aswinpraabu/RC-CAR/Hardware_Files/Front Wheel Hub.png

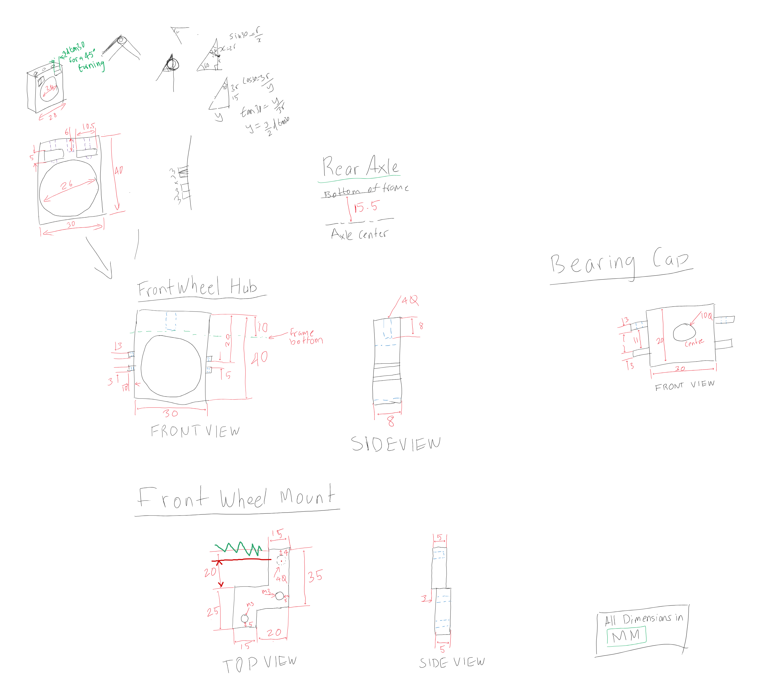
Hardware_Files/Front Wheel Hub.png
