aswinpraabu/RC-CAR/Hardware_Files/FreeCAD_Project_Files/Front_Wheel_Mount.FCStd

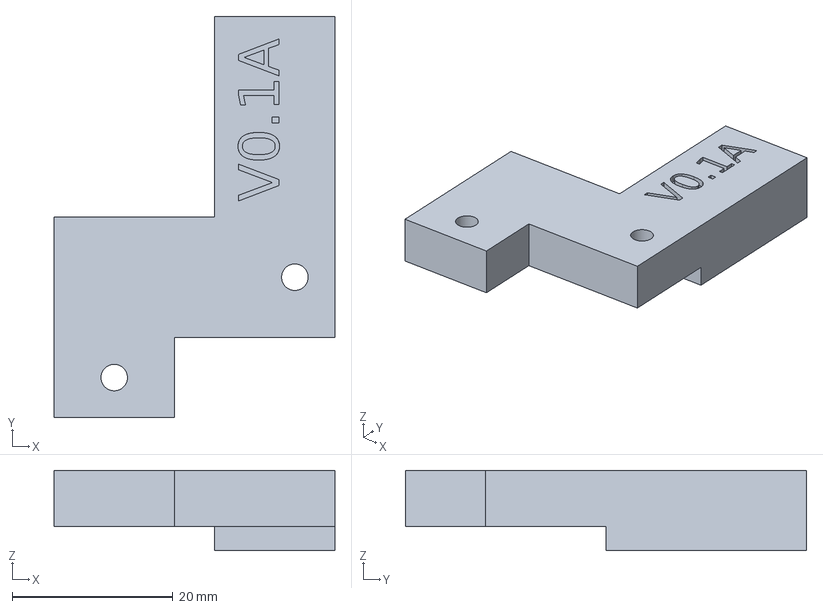
[picture p2: CAD file, 2025-08-28]
Hardware_Files/FreeCAD_Project_Files/Front_Wheel_Mount.FCStd
35.0 x 50.0 x 10.0 mm
