aswinpraabu/RC-CAR/Hardware_Files/FreeCAD_Project_Files/Front_Wheel_Hub.FCStd

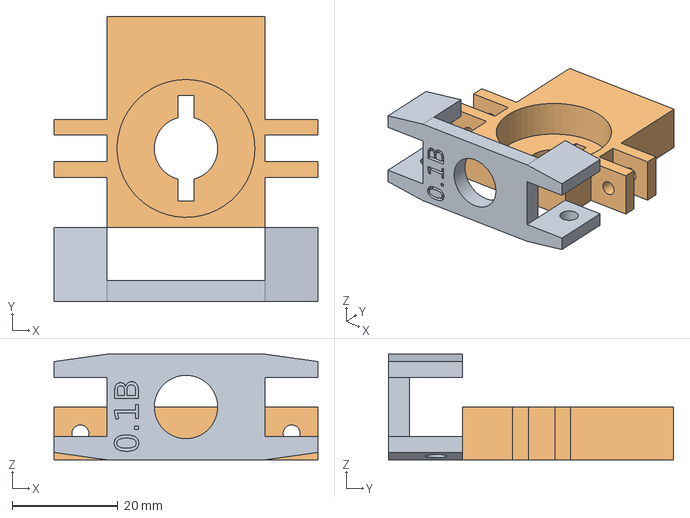
[picture p3: CAD file, 2025-08-28]
Hardware_Files/FreeCAD_Project_Files/Front_Wheel_Hub.FCStd
50.0 x 54.0 x 20.0 mm
Bearing_Cap_V0.1B
Wheel_Hub_V0.1A
