aswinpraabu/RC-CAR/Hardware_Files/FreeCAD_Project_Files/Frame.FCStd

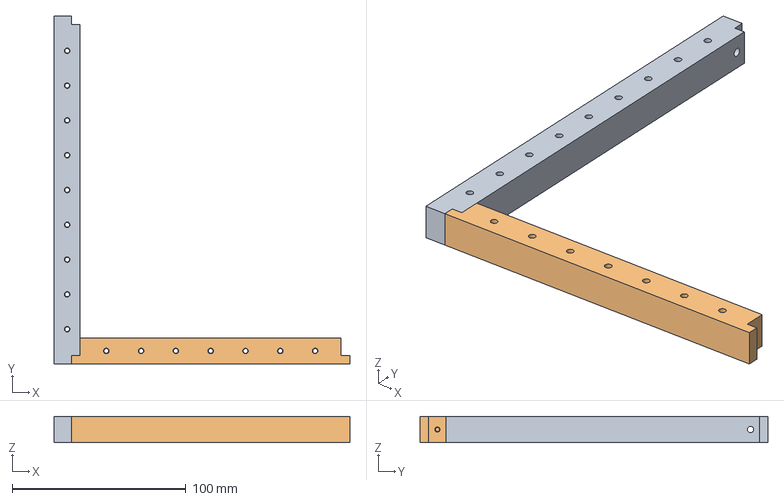
[picture p4: CAD file, 2025-02-16]
Hardware_Files/FreeCAD_Project_Files/Frame.FCStd
170.0 x 200.0 x 15.0 mm
Side_Frame
