aswinpraabu/RC-CAR/(threads)

Thread 3 (2025-02-16):

[HW Feature] Front Axle & Steering (Driven Axle) Proto1

aswinpraabu, 2025-02-16:
**Describe the feature**
Design, make and assemble the  Front Axle & Steering system
- [ ] Make part(s) that attaches the front wheels and can rotate around the z-axis (perpendicular to the ground)
- [ ] Make parts for the steering system
- [ ] Assemble everything

**Describe implementation ideas you've considered**

- To make a wheel hub that attaches to the frame (or another part fixed to the frame) with a dowel pin
  - The frame essentially sits on the wheels. If the car is lifted with the frame the wheels will fall off :D. Need to come up with something better later
- Two more dowel pins on each wheel hub to attach two rods that will together form a parrallelogram.
  - A servo motor will provide steering

aswinpraabu, 2025-03-22:
Abandoning Proto1 as it's pretty unstable and poorly designed

Closed 2025-03-20.

Thread 6 (2025-02-16):

[HW Feature]  Servo Motor for Steering

aswinpraabu, 2025-02-16:
**Describe the feature**
Choose & purchase a Servo Motor for the steering system

aswinpraabu, 2025-04-13:
SG90 Servo Motor

Closed 2025-04-13.

Thread 7 (2025-02-20):

[HW Issue] It is difficult to remove the bearing from the Front Wheel Hub

aswinpraabu, 2025-02-20:
**Describe the bug**
 - There's no easy way to remove bearing from the Front Wheel Hub

aswinpraabu, 2025-02-21:
[commit 4c8498c](https://github.com/aswinpraabu/RC-CAR/commit/4c8498cbe6873c0d7bac48105ede0b8033901ee6) fixes this

aswinpraabu, 2025-02-21:
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

Closed 2025-02-22.

Thread 8 (2025-02-20):

[HW Issue] Bearing Cap doesn't fit onto the Front Wheel Hub

aswinpraabu, 2025-02-20:
**Describe the bug**
The dimensions of the cavity in the Bearing Cap should be slightly increased to acount for printing tolerances

aswinpraabu, 2025-02-21:
Likely don't need to make changes as later prints fit well

Closed 2025-02-28.

Thread 10 (2025-02-21):

[HW Issue] Hole size for the axle in the Front wheel hub is too small

aswinpraabu, 2025-02-21:
**Describe the bug**
The size is the exact size of the axle. This could lead to unwanted friction between the axle & the hub

aswinpraabu, 2025-02-21:
[commit deafaa0](https://github.com/aswinpraabu/RC-CAR/commit/deafaa024a08d10c39b107264ef8e12765498109) fixes this

Closed 2025-02-22.

Thread 11 (2025-02-21):

[HW Issue] Print fails for the front wheel mount

aswinpraabu, 2025-02-21:
**Describe the bug**
The fillet makes the print fail

aswinpraabu, 2025-02-21:
[commit ec0d887](https://github.com/aswinpraabu/RC-CAR/commit/ec0d887e8b5a94393507b226e7519ec388fa1986)

Closed 2025-02-22.

Thread 12 (2025-02-21):

[HW Issue] The hole in the Bearing cap doesn't allign with the hole in the hub

aswinpraabu, 2025-02-21:
**Describe the bug**

Closed 2025-02-22.

Thread 9 (2025-02-21):

[HW Issue] Bearing Cap doesn't have a cavity which blocks the axle

aswinpraabu, 2025-02-21:
**Describe the bug**

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

aswinpraabu, 2025-02-21:
[commit c9b6083](https://github.com/aswinpraabu/RC-CAR/commit/c9b608333f4c41ff2e303234c01f839d3ba8c90e) fixes this

Closed 2025-02-22.

Thread 13 (2025-02-22):

[HW Issue] The wheel hub cannot turn while mounted

aswinpraabu, 2025-02-22:
**Describe the bug**
There's no clearance between the hub & frame to allow the Hub to rotate
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

aswinpraabu, 2025-02-22:
[commit af77648](https://github.com/aswinpraabu/RC-CAR/commit/af776487be98671246623b77c50b3347bbf78bdb)

Thread 14 (2025-02-23):

[HW Issue] Bearing cap needs a cavity in the bottom to hold the dowel pin

aswinpraabu, 2025-02-23:
**Describe the bug**

Closed 2025-02-23.

Thread 22 (2025-04-05):

[HW Feature] Steering Servo Motor Mount

aswinpraabu, 2025-04-05:
**Describe the feature**

**Describe implementation ideas you've considered**

aswinpraabu, 2025-04-13:
SG90 Servo Motor

Closed 2025-05-04.

Thread 25 (2025-04-05):

[HW Issue] Spindle Bracket wobbles after mouting to the frame. Single fastening point is not enough

aswinpraabu, 2025-04-05:
**Describe the bug**

Closed 2025-05-04.

Thread 26 (2025-04-12):

[HW Issue] Need a stopper for the wheel to secure it to the axle

aswinpraabu, 2025-04-12:
**Describe the bug**

Closed 2025-05-10.

Thread 27 (2025-04-12):

[HW Issue] The length of the spindle is incorrect

aswinpraabu, 2025-04-12:
**Describe the bug**
The length of the spindle needs to be re-calculated to prevent the front wheel from making contact with the frame when turning

Closed 2025-05-04.

Thread 28 (2025-04-12):

[HW Issue] Spindle Bracket dimensions are incorrect

aswinpraabu, 2025-04-12:
**Describe the bug**
The dimensions of the spindle bracket needs to be re-calculated to prevent the front wheel from making contact with the frame when turning

Closed 2025-05-03.

Thread 30 (2025-05-03):

[HW Issue] The Servo mount needs screw holes to fasten the servo

aswinpraabu, 2025-05-03:
**Describe the bug**

Closed 2025-05-04.

Thread 31 (2025-05-04):

[HW Issue] Servo doesn't fit into the mount properly

aswinpraabu, 2025-05-04:
**Describe the bug**

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

Closed 2025-05-04.

Thread 35 (2025-05-04):

[HW Issue] Move the Rear Bearing mounts towards the edge of the frame to reduce bending stress on the rear axles

aswinpraabu, 2025-05-04:
**Describe the bug**

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

Closed 2025-05-07.

Thread 39 (2025-05-04):

[HW Feature] Rear wheel lock

aswinpraabu, 2025-05-04:
**Describe the feature**
A part to secure the rear wheel to the axle

aswinpraabu, 2025-05-06:
Don't need this, the axle will be secured to the wheel directly with a screw

Closed 2025-05-10.

Thread 40 (2025-05-06):

[HW Issue] Rear axle doesn't have a screw hole to be secured to the wheel

aswinpraabu, 2025-05-06:
**Describe the bug**

Thread 41 (2025-05-07):

[HW Issue] The Rear Axle is short by 7.5mm

aswinpraabu, 2025-05-07:
**Describe the bug**

Thread 42 (2025-05-07):

[HW Issue] The Rear Axle doesn't have a screw hole to be able the secure the wheel

aswinpraabu, 2025-05-07:
**Describe the bug**

Thread 47 (2025-05-10):

[HW Issue] Spacing between screw holes for the motor driver is a little too short

aswinpraabu, 2025-05-10:
**Describe the bug**
The current distance between the screw holes is 36mm. One of the sides can be a slot instead of a circle for better flexibility

The screw currently has to be driven at an angle in order to secure the motor mount.

Thread 48 (2025-05-10):

[HW Issue] Motor mount needs some cavity to through hole pins below the PCB

aswinpraabu, 2025-05-10:
**Describe the bug**

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

Closed 2025-06-01.
