aswinpraabu/RC-CAR/Software_Files/CCM/CCM_Submodules/hw_drivers.py

from CCM_Submodules.global_data import hw_drivers_data, rf_comms_data, controls_data
from CCM_Submodules.global_data import POWER_MODES, diagnostics_class
from machine import SPI, Pin,PWM, soft_reset, I2C
from CCM_Submodules.calibrations import HW_DRIVERS_Calibrations as CAL
from CCM_Libraries.ina260 import INA260, AveragingCount, ConversionTime
from time import sleep_ms, ticks_diff, ticks_ms

# region RFM69
# Define pin numbers for RFM69 module
RFM69_MOSI_PIN = 19
RFM69_MISO_PIN = 16
RFM69_SCK_PIN = 18
RFM69_CS_PIN = 17
RFM69_RESET_PIN = 20
a = PWM(Pin(RFM69_MOSI_PIN), freq=1000000)  # Example PWM initialization, adjust as needed
a.duty_ns()

# endregion
SERVO_PIN = 21
LED2_LOC_RCM_PIN = 'LED'

MOTOR_FWD_PIN = 11
MOTOR_REV_PIN = 10

POWER_ON_PIN_NUM = 13
POWER_ON_PIN = Pin(POWER_ON_PIN_NUM, Pin.OUT)
POWER_ON_PIN.value(1)  # Set high to power on the system

LED2 = Pin(LED2_LOC_RCM_PIN, Pin.OUT)
LED2.value(0)  # Turn off LED initially

# region INA260 
# (I2C) - Battery Voltage and Current Sensor
# I2C pins
I2C_SCL_PIN = 5
I2C_SDA_PIN = 4

INA260_ADDR = 0x40
# endregion

class Servo:
    def __init__(self):
        pass

    def configure_pin(self, pin):

        # Initialize the parameters for the SG90 servo motor
        self.pin = Pin(pin, Pin.OUT)
        self.angle = 0  # Initialize angle to 0 degrees
        self.min_angle = -90.0  # Minimum angle
        self.max_angle = 90.0 # Maximum angle
        self.min_duty_ns = 1.0e6 # (1ms) Minimum duty cycle in nanoseconds
        self.max_duty_ns = 2.0e6 # (2ms)Maximum duty cycle in nanoseconds
        self.freq = CAL.CAL_f_servo_freq

        self.min_duty_offset_ms = CAL.CAL_t_servo_min_duty_offset_ms # Offset for minimum duty cycle
        self.max_duty_offset_ms = CAL.CAL_t_servo_max_duty_offset_ms # Offset for maximum duty cycle
        self.min_duty_ns += int(self.min_duty_offset_ms * 1e6)  # Convert ms to ns
        self.max_duty_ns += int(self.max_duty_offset_ms * 1e6)  # Convert ms to ns
        
        self.pwm = PWM(self.pin, freq=self.freq)


    def set_angle(self, angle):
        self.angle = angle
        
        duty_ns = self._angle_to_duty_ns(angle)
        self.pwm.duty_ns(duty_ns)

    def _angle_to_duty_ns(self, angle: float) -> int:
        '''
        Convert angle to duty cycle in ns
        '''
        duty_ns:int = 0
        if angle < self.min_angle or angle > self.max_angle:
            print(f"Angle must be between {self.min_angle} and {self.max_angle} degrees")
            duty_ns = int(( self.max_duty_ns + self.min_duty_ns)/2)
        else:    
            factor = (self.max_duty_ns - self.min_duty_ns)/(self.max_angle - self.min_angle)
            duty_ns = int((angle - self.min_angle) * factor + self.min_duty_ns)
        #print(f"Setting servo angle to {angle} degrees, duty_ns: {duty_ns}")
        return duty_ns

class DC_Motor:
    def __init__(self):
        pass
    def configure_pin(self, forward_pin_num, reverse_pin_num):
        # Initialize the parameters for the DC motor
        self.forward_pin = Pin(forward_pin_num, Pin.OUT)
        self.reverse_pin = Pin(reverse_pin_num, Pin.OUT)

        self.frequency = 1000  # Frequency for PWM
        self.forward_pwm = PWM(self.forward_pin, freq=self.frequency)
        self.reverse_pwm = PWM(self.reverse_pin, freq=self.frequency)
        self.forward_pwm.duty_ns(0)  # Initialize duty cycle to 0
        self.reverse_pwm.duty_ns(0)  # Initialize duty cycle to 0

        self.power = 0 #Positive power for forward, negative for reverse
        self.min_power = -100  # Minimum power
        self.max_power = 100  # Maximum power
    def set_power(self, power):
        # Set the power of the motor
        
        #print(f"Setting motor power to {power}, duty_ns: {duty_ns}")

        if power > 0:
            duty_ns = self._power_to_duty_ns(power)
            self.forward_pwm.duty_ns(duty_ns)
            self.reverse_pwm.duty_ns(0)
        elif power < 0:
            duty_ns = self._power_to_duty_ns(power*CAL.CAL_p_dc_motor_reverse_factor/100)
            self.forward_pwm.duty_ns(0)
            self.reverse_pwm.duty_ns(int(duty_ns)) # Reverse motor at half power
        else:
            self.forward_pwm.duty_ns(0)
            self.reverse_pwm.duty_ns(0)
        
        
    def _power_to_duty_ns(self, power: float) -> int:
        '''
        Convert power to duty cycle in ns. Period is 1/freqency = 1/1000Hz = 1ms = 1000000ns
        '''
        duty_ns:int = 0
        is_in_range = self.min_power <= power <= self.max_power
        if not is_in_range:
            print(f"power must be between {self.min_power} and {self.max_power}")
            duty_ns = 0
        else:    
            #TODO this deadzone logic should account for battery voltage and current load
            # Actual deadzone may increase if battery voltage is low or motor is under load
            factor = (self.max_power - CAL.CAL_p_dc_motor_deadzone)/self.max_power 
            power_scaled = abs(power) * factor + CAL.CAL_p_dc_motor_deadzone # Scale power to overcome motor deadzone
            #print(f"Power: {power}, Scaled Power: {power_scaled}")
            duty_ns = int((power_scaled * 10000)) # percent to ns
        return duty_ns

steering_servo = Servo()
propulsion_motor = DC_Motor()
def initialize():
    print("Initializing hardware drivers...")

    # Initialize INA260 sensor
    global ina260_sensor
    i2c_obj = I2C(0, scl=Pin(I2C_SCL_PIN), sda=Pin(I2C_SDA_PIN))
    ina260_sensor = INA260(i2c_obj, INA260_ADDR)
    if ina260_sensor.init_success:
        ina260_sensor.voltage_conversion_time = CAL.CAL_t_ina260_voltage_conversion_time
        ina260_sensor.current_conversion_time = CAL.CAL_t_ina260_current_conversion_time
        ina260_sensor.averaging_count = CAL.CAL_n_ina260_averaging_count

    # Initialize RFM69 SPI and pins
    hw_drivers_data.rfm69_SPI = SPI(
                                    0,
                                    baudrate=500_000,
                                    polarity=0,
                                    phase=0,
                                    bits=8,
                                    firstbit=SPI.MSB,
                                    sck=Pin(RFM69_SCK_PIN),# type: ignore
                                    mosi=Pin(RFM69_MOSI_PIN),# type: ignore
                                    miso=Pin(RFM69_MISO_PIN)# type: ignore
                                    )
    hw_drivers_data.rfm69_CS = Pin(RFM69_CS_PIN, Pin.OUT)
    hw_drivers_data.rfm69_RESET = Pin(RFM69_RESET_PIN, Pin.OUT)

    steering_servo.configure_pin(SERVO_PIN)
    propulsion_motor.configure_pin(MOTOR_FWD_PIN, MOTOR_REV_PIN)

    hw_drivers_data.battery_voltage_low_warn_diag = diagnostics_class(
                                    id=1,
                                    name="Battery Voltage Low Warn",
                                    mature_time=CAL.CAL_t_battery_low_warn_mature_time_ms,
                                    demature_time=CAL.CAL_t_battery_low_warn_demature_time_ms
                                    )
    hw_drivers_data.battery_voltage_low_critical_diag =  diagnostics_class(
                                    id=2,
                                    name="Battery Voltage Low Critical",
                                    mature_time=CAL.CAL_t_battery_low_critical_mature_time_ms,
                                    demature_time=CAL.CAL_t_battery_low_critical_demature_time_ms
                                    )

# region Ouput
def led_control():
    LED2.value(controls_data.led2_loc_rcm)

def motor_control():

    #steering_servo.set_angle(controls_data.car_turn_angle)
    propulsion_motor.set_power(controls_data.car_throttle)
    #print(f"Steering angle: {controls_data.car_turn_angle}, Motor power: {controls_data.car_throttle}")

def power_control():
    if controls_data.power_mode == POWER_MODES.Shutdown:
        POWER_ON_PIN.value(0)

# endregion

# region input
def read_battery_voltage():
    if ina260_sensor.init_success:
        voltage = ina260_sensor.voltage  # Voltage 
        hw_drivers_data.battery_voltage = voltage  # Convert to volts
        hw_drivers_data.battery_voltage_validity = True  # Assume reading is valid for now
    else:
        hw_drivers_data.battery_voltage = 0.0
        hw_drivers_data.battery_voltage_validity = False

def read_battery_current():
    if ina260_sensor.init_success:
        current = ina260_sensor.current  # Current in milliamps
        hw_drivers_data.battery_current = current  # Already in milliamps
        hw_drivers_data.battery_current_validity = True  # Assume reading is valid for now
    else:
        hw_drivers_data.battery_current = 0.0
        hw_drivers_data.battery_current_validity = False

# endregion

def hw_drivers_diagnostics():
    #TODO [RC-78,RC-77]: Add diagnostics for battery voltage

    if hw_drivers_data.battery_voltage_validity:
        # Check Battery Voltage Critical first
        if hw_drivers_data.battery_voltage < CAL.CAL_v_battery_low_critical:
            hw_drivers_data.battery_voltage_low_critical_diag.test_fail()
        else:
            hw_drivers_data.battery_voltage_low_critical_diag.test_pass()

        # Then check Battery Voltage Warn
        if hw_drivers_data.battery_voltage < CAL.CAL_v_battery_low_warn:
            hw_drivers_data.battery_voltage_low_warn_diag.test_fail()
        else:
            hw_drivers_data.battery_voltage_low_warn_diag.test_pass()
    
            
    #TODO [RC-92]:Add diagnostics for current sensors
    pass


def task_005ms():
    '''
    This function is called every 5ms to update the servo position based on the received data.
    '''
    motor_control()
    read_battery_current()

def task_100ms():
    led_control()
    power_control()
    read_battery_voltage()
    hw_drivers_diagnostics()
    #print(f"Battery Voltage: {hw_drivers_data.battery_voltage:.2f} V, Battery Current: {hw_drivers_data.battery_current:.2f} mA")


if __name__ == "__main__":
    initialize()
    while True:
        task_005ms()
        task_100ms()
        sleep_ms(500)
