aswinpraabu/RC-CAR/Software_Files/CCM/CCM_Submodules/controls.py

from CCM_Submodules.global_data import rf_comms_data, controls_data, hw_drivers_data
from CCM_Submodules.global_data import POWER_MODES, DIAG_STATUS
from time import ticks_ms, ticks_diff
from CCM_Submodules.calibrations import CONTROLS_Calibrations as CAL


Prepare_Shutdown_start_time = 0  # Time when Prepare_Shutdown mode started


def initialize():
    pass


def motor_control():
    #print(rf_comms_data.rx_validity, controls_data.power_mode)

    # Check if all conditions are met to enable driving
    comms_data_check = rf_comms_data.rx_validity
    power_mode_check = controls_data.power_mode == POWER_MODES.Normal
    safety_check = hw_drivers_data.battery_voltage_low_critical_diag.get_status() is not DIAG_STATUS.FAIL
    drive_enable = all([comms_data_check, power_mode_check, safety_check])

    if drive_enable:
        # Update car throttle and turn angle based on received data
        controls_data.car_throttle = rf_comms_data.rx_throttle
        controls_data.car_turn_angle = rf_comms_data.rx_turn_angle
    else:
        # If data is invalid or not in Normal mode, stop the car
        controls_data.car_throttle = 0
        
        


def power_control():
    global Prepare_Shutdown_start_time

    any_shutdown_condition = any([
        rf_comms_data.shutdown_request_confirmed,
        rf_comms_data.LOC_with_RCM_diag.get_status() is DIAG_STATUS.FAIL,
        hw_drivers_data.battery_voltage_low_critical_diag.get_status() is DIAG_STATUS.FAIL])

    
    if controls_data.power_mode == POWER_MODES.Normal and any_shutdown_condition:
        # Transition to Prepare_Shutdown mode
        controls_data.power_mode = POWER_MODES.Prepare_Shutdown
        
        Prepare_Shutdown_start_time = ticks_ms()
        print("Transitioning to Prepare_Shutdown mode")

    elif controls_data.power_mode == POWER_MODES.Prepare_Shutdown:
        elapsed_time = ticks_diff(ticks_ms(), Prepare_Shutdown_start_time)
        if elapsed_time >= CAL.CAL_t_Prepare_Shutdown_duration_ms:
            # Transition to Shutdown mode after the duration
            controls_data.power_mode = POWER_MODES.Shutdown
            print("Transitioning to Shutdown mode")

def warning_lights_control():
    controls_data.led2_loc_rcm = rf_comms_data.LOC_with_RCM





def task_005ms():
    # Update motor control based on received data
    motor_control()
    


def task_010ms():
    # Update power control if needed
    power_control()


def task_100ms():
    # Update warning lights based on communication status
    warning_lights_control()
    #print("Turn angle: {0}, Throttle: {1}, Power Mode: {2}".format(controls_data.car_turn_angle,controls_data.car_throttle, controls_data.power_mode))
