aswinpraabu/RC-CAR/(commit log)

2024-06-16 added data struct definitions needed for voltage diagnostics
2025-02-16 Moving all the software files into a new folder because I'm going to track hardware here too
2025-02-16 Adding the hardware folder with the CAD file for the frames
    [Frame.FCStd]
2025-02-20 Added reference sketch for the front wheel hub
2025-02-20 Made the Wheel Hub & Bearing Cap based on sketch
    [Front_Wheel_Hub.FCStd]
2025-02-21 Added a hole for the axle in the bearing cap
    [Front_Wheel_Hub.FCStd]
2025-02-21 Increased the holes size from 10mm to 12mm in the front bearing hub
    [Front_Wheel_Hub.FCStd]
2025-02-21 Added cuts in the Fron Bearing hub
    [Front_Wheel_Hub.FCStd]
2025-02-21 Created design of Front Wheel Mount based on sketch
    [Front_Wheel_Mount.FCStd]
2025-02-21 Adjusted to help with allignment issue with the cap
    [Front_Wheel_Hub.FCStd]
2025-02-21 Suppressed Fillet for now to help with better print bed adhesion
    [Front_Wheel_Mount.FCStd]
2025-02-22 Fixed the dimensioning of the front wheel mount
2025-02-22 Fixed the issue in the Front wheel mount being too short
    [Front_Wheel_Mount.FCStd]
2025-02-22 Added a version naming into the model
    [Front_Wheel_Mount.FCStd]
2025-02-23 Added a cavity in the bottom to hold the dowel pin
    [Front_Wheel_Hub.FCStd]
2025-06-25 fixed issues with importing global_data
    [hw_drivers.py]
2025-06-25 Finished implementing RF receiving. And fixed issues with receiving RF messages
    [rf_comms.py]
2025-06-25 Added a Servo class
2025-07-02 implement basic servo control functionality
2025-07-02 Creating module to control all actuators
2025-07-02 Added offsets to the min & max angle. To account for imperfect motors
2025-08-14 updated the getter function for turning & throttle to be more specific
2025-08-16 created the DC_Motor class to handle motor actuation
2025-08-16 added warning LEDs
2025-08-16 implemented functionality to drive the prop motor based on the output from "controls"
2025-08-16 Allow throttle input to accept [-50, 100] to allow for reversing
    [rf_comms.py]
2025-08-16 Changing to getting reverse throttle upto -100. But Drive the motor at 50% power when reversing
    [hw_drivers.py, rf_comms.py]
2025-08-16 Changed pin numbers for the propulsion motor
2025-08-17 RC-74 Moved the shutdown command reset logic, to allow reseting status even after confirming the command
    [rf_comms.py]
2025-08-17 implemented ability to set power pin low on shutdown
2025-08-17 don't reset the turn angle abruptly during shutdown. Retain last angle
    [controls.py]
2025-08-17 added power_control to 100ms task
2025-08-17 print statements
2025-08-17 RC-85 safely handle condition where CCM fails toconnect to the RF tranceiver
    [rf_comms.py]
2025-08-17 print statement
2025-08-19 Onboard LED Pin reference name changed in PICO 2 W
2025-08-19 RC-90 Assign the correct pin numbers
    [hw_drivers.py]
2025-08-19 RC-90 Fixed incorrect conversion from power to duty cycle for dc motor
    [hw_drivers.py]
2025-08-21 RC-83, RC-84 created a calibration to for the shutdown timeout
2025-08-22 RC-83 Define calibration variables in a separate file with a specific format
2025-08-25 RC-76 Pin configurations for INA260
2025-08-25 RC-76 Initialize the INA260 sensor
2025-08-25 RC-76 adding calibrations for INA260
2025-08-25 RC-76 added interfaces to provide voltage & current readings to other submodules
2025-08-25 declaring all the calibrations as constants
2025-08-26 RC-76 added functions to read the voltage & current
2025-08-26 Fixed conversion issue. The library already converts mv to volts
    [hw_drivers.py]
2025-08-26 RC-76 class RWBits was still for circuit python. Updated for micropython
2025-08-27 RC-68 RC-77 RC-78 added calibrations to required for detecting battery low voltage faults
2025-08-27 RC-68 RC-77 RC-78 adding interfaces for hw_drivers to provide the status of battery low voltage faults
2025-08-27 RC-68 RC-77 RC-78 implemented diagnostics to detect low battery voltage
2025-08-28 Reduced the font of the version number to fit better
    [Front_Wheel_Hub.FCStd]
2025-08-28 RC-96 change ">" to ">=" to include 0% throttle
2025-08-28 RC-98 Added checks to only access the INA260 sensor if it was successfully initialized
2025-08-28 RC-98 Added a check to verify the sensor is communicating during init of INA260
2025-08-29 RC-79 added logic to disable motors if battery is critically low
2025-08-29 RC-79 only disable motors if the voltage low condition is detected. So we don't wait for the test to pass in the beginning
2025-08-29 RC-87 included critical battery low as shutdown condition
2025-08-30 RC-91 Scale the power to overcome motor dead zone with whining noise
    [calibrations.py, hw_drivers.py]
2025-08-30 RC-91 Fixed logic so that 0% input isn't converted to min deadzone power
    [hw_drivers.py]
2025-08-30 RC-91 Scaling down the reverse power before the deadzone scaling
    [hw_drivers.py]
2025-08-30 RC-65 only send 0 throttle when the raw throttle value is less than 10%.
2025-10-05 Disabled servo motor based steering as it is not used in the newer hw design
2025-12-30 Change pin configurations to match the latest PCB design
